sergey12malyshev/Smart-power-supply-350W/README.txt

Программный проект импульсного источника питания.
Среда компиляции:KEIL.uVision V5.34.0.0
Настройка периферии: STM32 CubeMX
Контроллер: STM32F103C8T6
RTOS:FreeRTOS Kernel V10.0.1 (https://microtechnics.ru/stm32cubemx-bystryj-start-s-freertos-dlya-stm32/)
Сборка: Proba.BAT (Options for target ... -> Вкладка "Output" -> Галка "Create batch file")
