sergey12malyshev/Smart-power-supply-350W/hardware/picturies/CLI.bmp

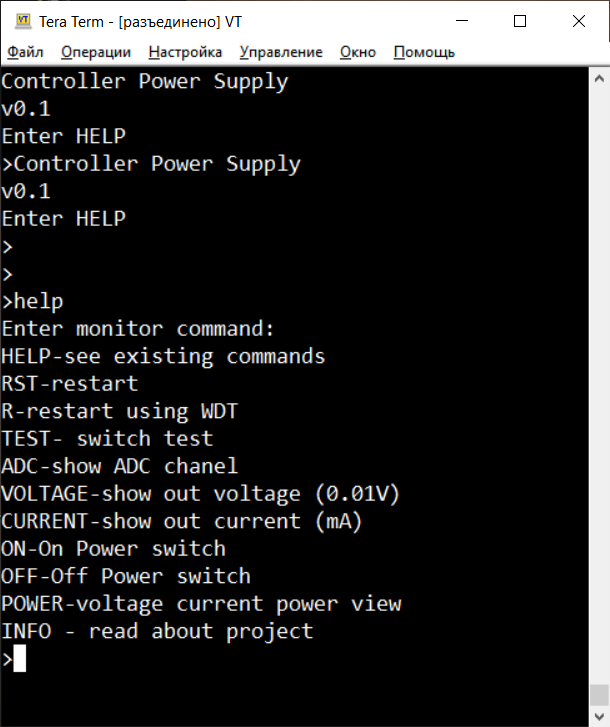
hardware/picturies/CLI.bmp
