sergey12malyshev/Smart-power-supply-350W/hardware/picturies/Модель LTSpice.png

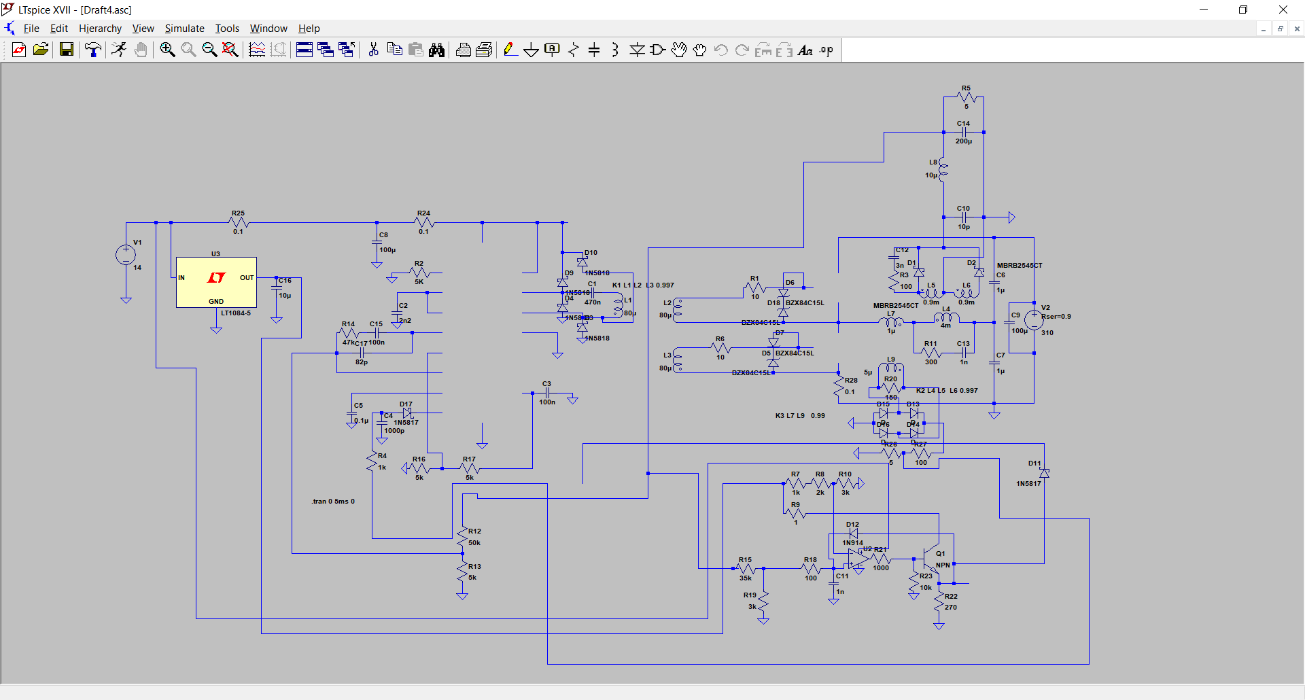
hardware/picturies/Модель LTSpice.png
