sergey12malyshev/Smart-power-supply-350W/hardware/shemes/Э1 Схема структурная.pdf

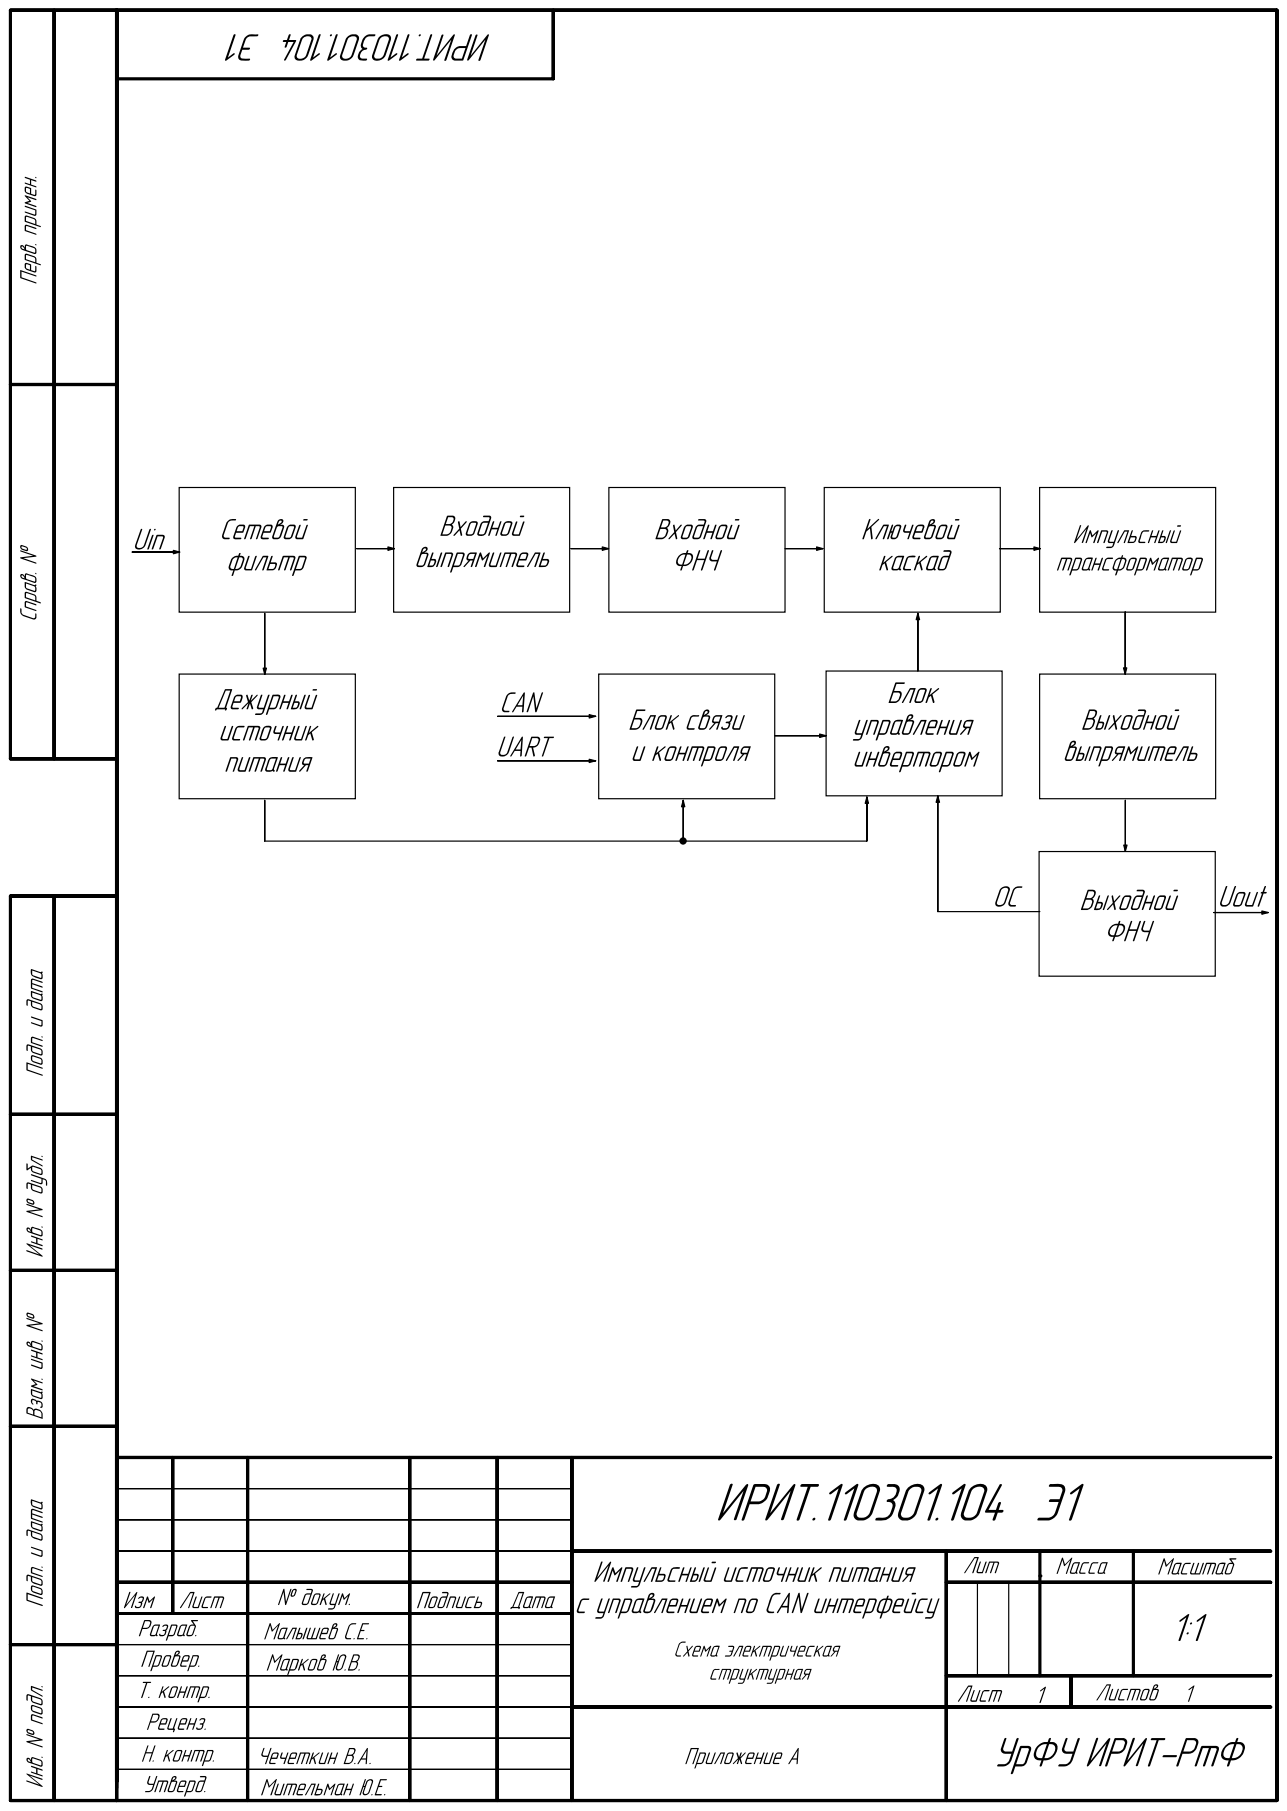
[picture p6: page 1]
