sergey12malyshev/Smart-power-supply-350W/hardware/shemes/Э3 Модуль связи и контроля.pdf

DA5

a[7..0]

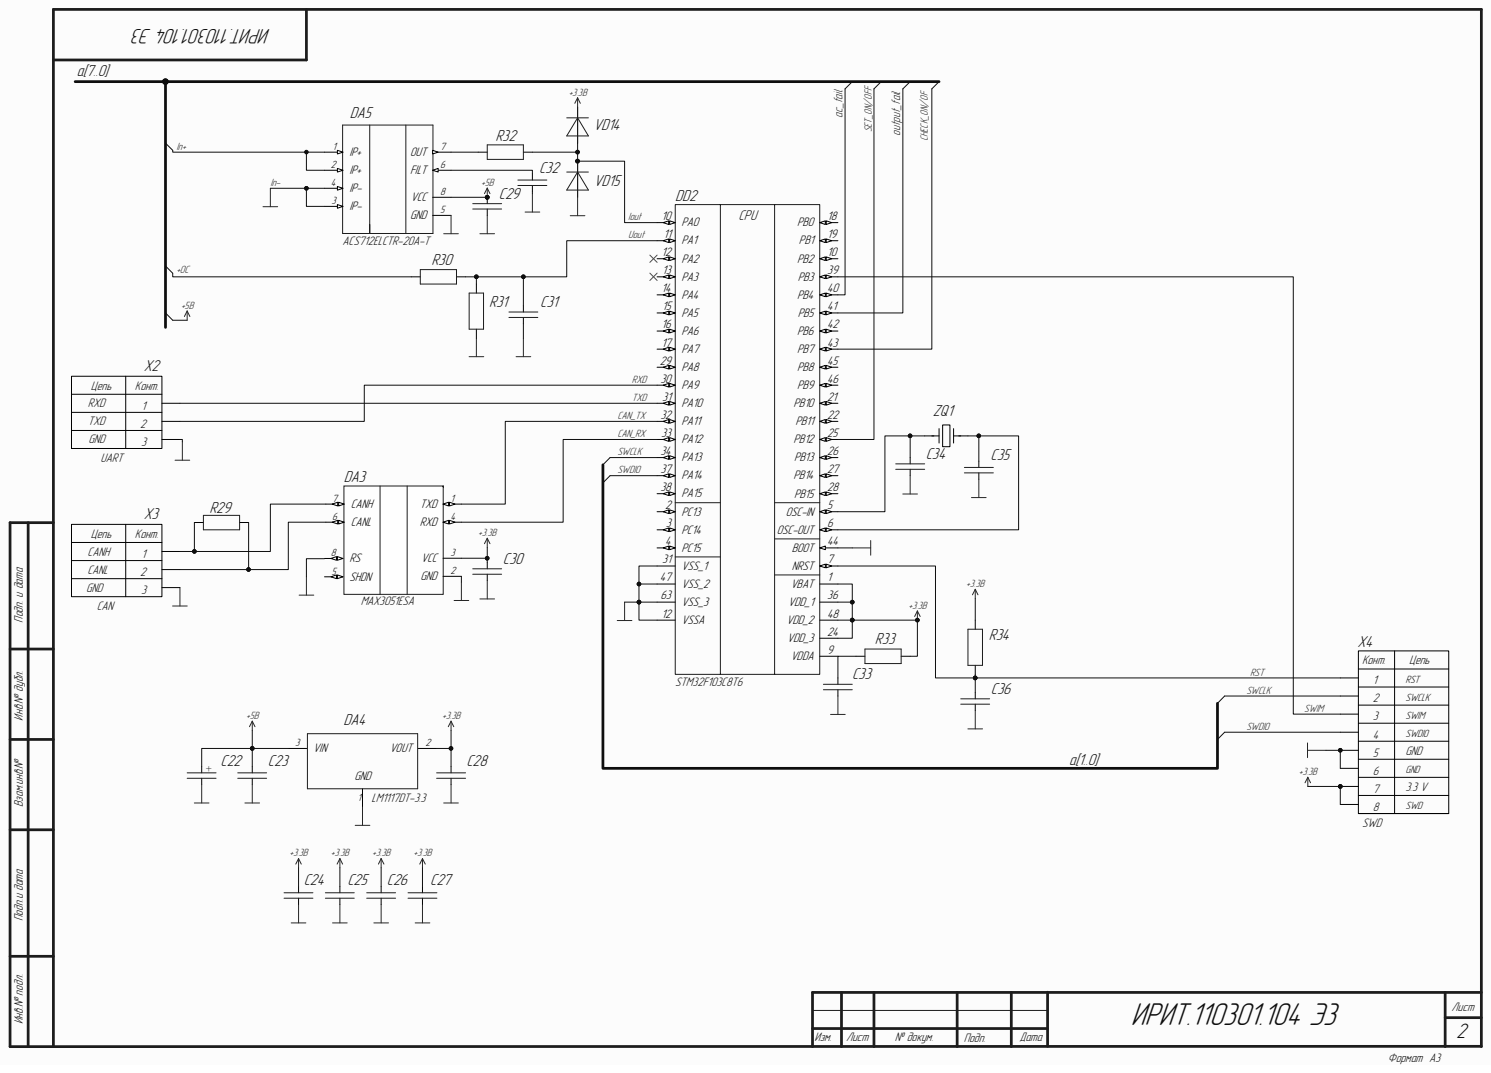
[picture p7: page 1]

Èíâ.¹ ïîäë. Ïîäï.è äàòà Âçàì.èíâ.¹ Èíâ.¹ äóáë. Ëèñò

ÈÐÈÒ.110301.104 Ý3

Èçì. | Ëèñò | ¹ äîêóì. | Ïîäï. | Äàòà
