sergey12malyshev/Smart-power-supply-350W/hardware/shemes/Э3 Модуль управления преобразованием и защит.pdf

C13

DA2

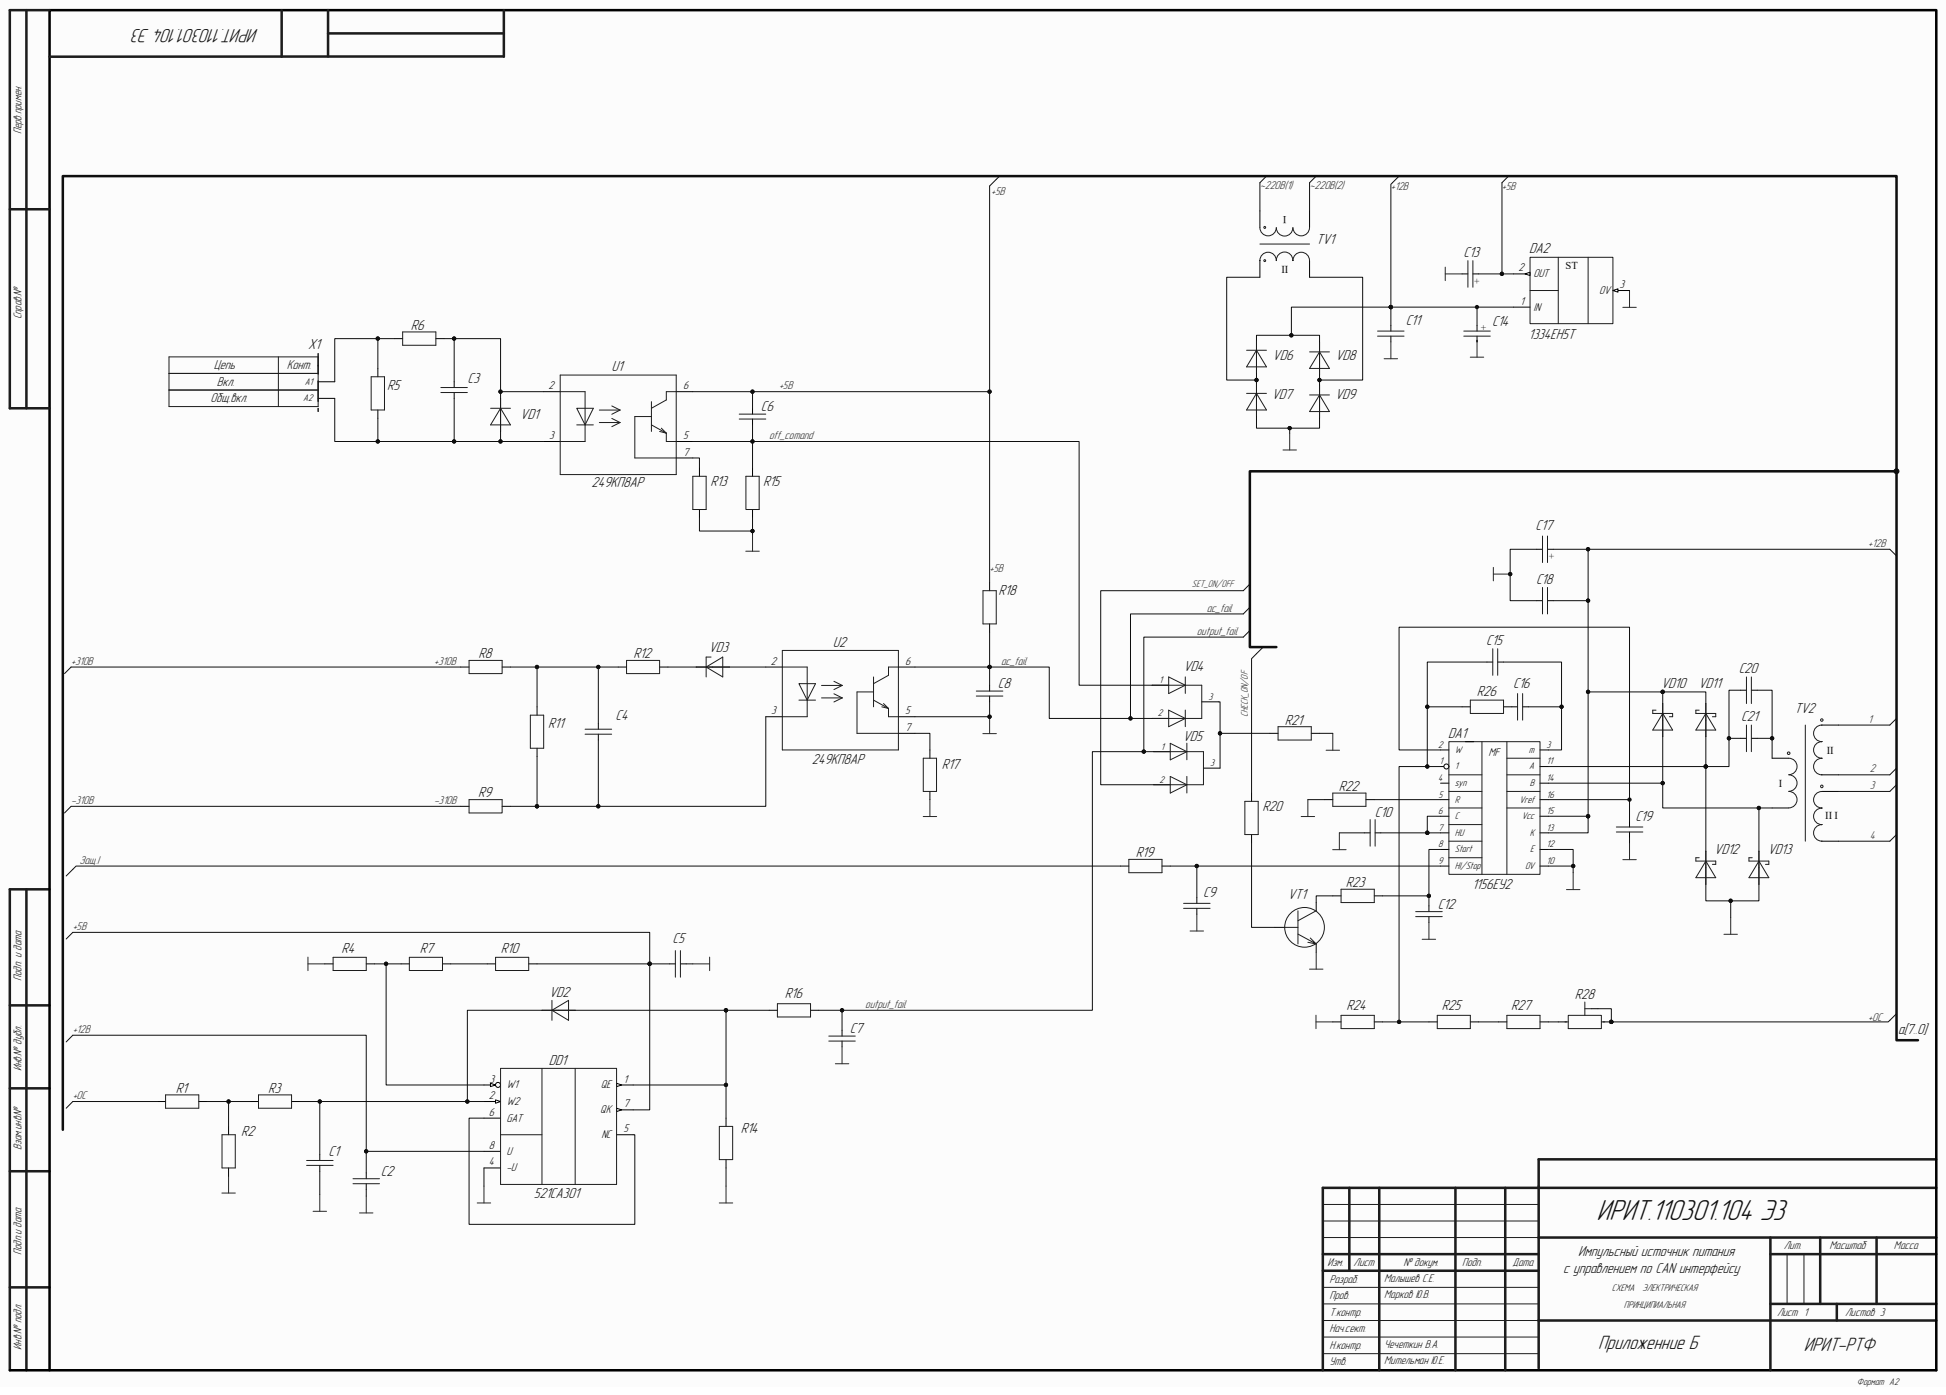
[picture p8: page 1]

Öåïü | Êîíò.
Âêë. | A1

Èíâ.¹ ïîäë. Ïîäï.è äàòà Âçàì.èíâ.¹ Èíâ.¹ äóáë. Ïîäï. è äàòà

Èìïóëüñíûé èñòî÷íèê ïèòàíèÿ
ñ óïðàâëåíèåì ïî CAN èíòåðôåéñó

Èçì. | Ëèñò | ¹ äîêóì. | Ïîäï. | Äàòà
Ðàçðàá. | | Ìàëûøåâ Ñ.Å.
Ïðîâ. | | Ìàðêîâ Þ.Â.
Ò.êîíòð. Íà÷.ñåêò.

Í.êîíòð. | | ×å÷åòêèí Â.À.
