sergey12malyshev/Smart-power-supply-350W/hardware/shemes/Э3 Силовой модуль.pdf

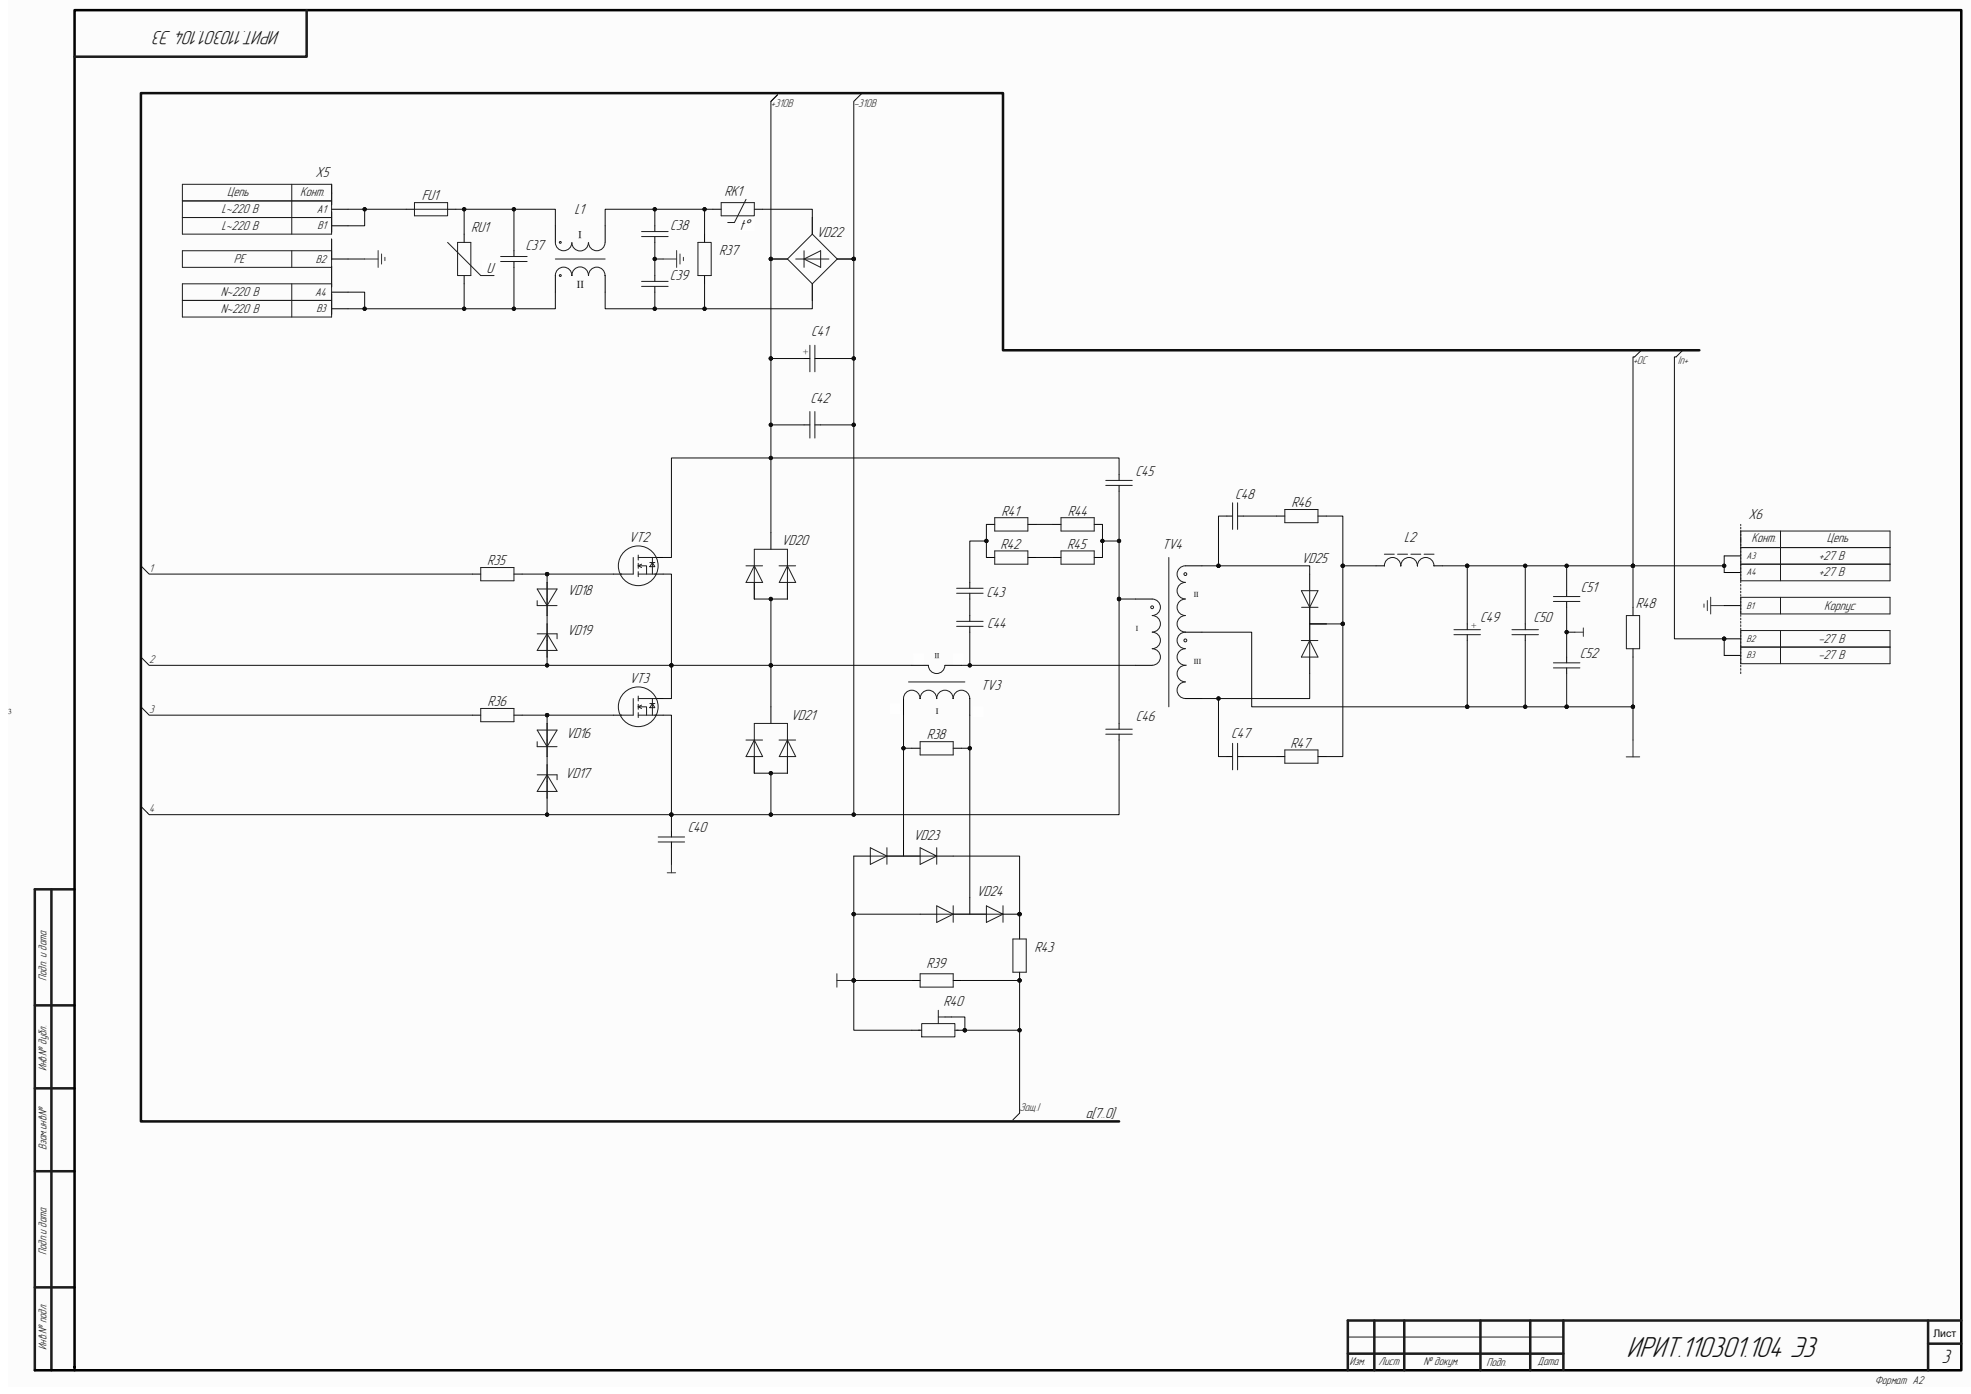
[picture p9: page 1]

Öåïü | Êîíò.
L~220 Â | A1

N~220 Â | A4
N~220 Â | B3

A3 | +27 Â
A4 | +27 Â

B2 | -27 Â
B3 | -27 Â

Èíâ.¹ ïîäë. Ïîäï.è äàòà Âçàì.èíâ.¹ Èíâ.¹ äóáë. Ïîäï. è äàòà
