sergey12malyshev/Smart-power-supply-350W/(list of files, drawings)

Other design files:
hardware/pcb/SMPS24.lay
hardware/pcb/Плата защиты.lay
