sergey12malyshev/Smart-power-supply-350W/Core/Src/main.c

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
/* Includes ------------------------------------------------------------------*/
#include "main.h"
#include "cmsis_os.h"

/* USER CODE BEGIN Includes */
#include <stdio.h>
#include <string.h>	
#include <stdbool.h>
#include "task.h"
#include "hardware.h"
#include "mainTask.h"
#include "monitorTask.h"
#include "checkTask.h"
#include "ADC.h"
/* USER CODE END Includes */

ADC_HandleTypeDef hadc1;
ADC_HandleTypeDef hadc2;

IWDG_HandleTypeDef hiwdg;

UART_HandleTypeDef huart1;

/* Definitions for defaultTask */
osThreadId_t defaultTaskHandle;
const osThreadAttr_t defaultTask_attributes = {
  .name = "defaultTask",
  .stack_size = 128 * 4,
  .priority = (osPriority_t) osPriorityNormal,
};
/* Definitions for mainTask */
osThreadId_t mainTaskHandle;
const osThreadAttr_t mainTask_attributes = {
  .name = "mainTask",
  .stack_size = 128 * 4,
  .priority = (osPriority_t) osPriorityLow,
};
/* Definitions for checkTask */
osThreadId_t checkTaskHandle;
const osThreadAttr_t checkTask_attributes = {
  .name = "checkTask",
  .stack_size = 128 * 4,
  .priority = (osPriority_t) osPriorityLow,
};
/* Definitions for monitorTask */
osThreadId_t monitorTaskHandle;
const osThreadAttr_t monitorTask_attributes = {
  .name = "monitorTask",
  .stack_size = 128 * 4,
  .priority = (osPriority_t) osPriorityLow,
};
void SystemClock_Config(void);
static void MX_GPIO_Init(void);
static void MX_USART1_UART_Init(void);
static void MX_ADC1_Init(void);
static void MX_ADC2_Init(void);
static void MX_IWDG_Init(void);
void StartDefaultTask(void *argument);
void StartMainTask(void *argument);
void StartCheckTask(void *argument);
void StartMonitorTask(void *argument);

/**
  * @brief  The application entry point.
  * @retval int
  */
int main(void)
{
  /* MCU Configuration--------------------------------------------------------*/

  /* Reset of all peripherals, Initializes the Flash interface and the Systick. */
  HAL_Init();

  /* Configure the system clock */
  SystemClock_Config();

  /* Initialize all configured peripherals */
  MX_GPIO_Init();
  MX_USART1_UART_Init();
  MX_ADC1_Init();
  MX_ADC2_Init();
  MX_IWDG_Init();
  /* USER CODE BEGIN 2 */
  HAL_ADCEx_Calibration_Start(&hadc1);
  
  off_ps(); 

  clear_uart_buff();
  UART_receve_IT();
  sendUART_hello();
  HAL_NVIC_EnableIRQ(EXTI15_10_IRQn);

  if (adc2_convertion() >= 3030) /* При сбросе пропускаем калибровку, если была нагрузка*/
  {
    calibr_zero_AD712();
  }
  else 
  {
    setZeroAD712(2450); // установим значение по умолчанию
  }
  
  /* USER CODE END 2 */

  /* Init scheduler */
  osKernelInitialize();

  /* USER CODE BEGIN RTOS_MUTEX */
  /* add mutexes, ... */
  /* USER CODE END RTOS_MUTEX */

  /* USER CODE BEGIN RTOS_SEMAPHORES */
  /* add semaphores, ... */
  /* USER CODE END RTOS_SEMAPHORES */

  /* USER CODE BEGIN RTOS_TIMERS */
  /* start timers, add new ones, ... */
  /* USER CODE END RTOS_TIMERS */

  /* USER CODE BEGIN RTOS_QUEUES */
  /* add queues, ... */
  /* USER CODE END RTOS_QUEUES */

  /* Create the thread(s) */
  /* creation of defaultTask */
  defaultTaskHandle = osThreadNew(StartDefaultTask, NULL, &defaultTask_attributes);

  /* creation of mainTask */
  mainTaskHandle = osThreadNew(StartMainTask, NULL, &mainTask_attributes);

  /* creation of checkTask */
  checkTaskHandle = osThreadNew(StartCheckTask, NULL, &checkTask_attributes);

  /* creation of monitorTask */
  monitorTaskHandle = osThreadNew(StartMonitorTask, NULL, &monitorTask_attributes);

  /* USER CODE BEGIN RTOS_THREADS */
  /* add threads, ... */
  /* USER CODE END RTOS_THREADS */

  /* USER CODE BEGIN RTOS_EVENTS */
  /* add events, ... */
  /* USER CODE END RTOS_EVENTS */

  /* Start scheduler */
  osKernelStart();

  /* We should never get here as control is now taken by the scheduler */
  /* Infinite loop */
  /* USER CODE BEGIN WHILE */
  while (1)
  {
    /* USER CODE END WHILE */

    /* USER CODE BEGIN 3 */
  }
  /* USER CODE END 3 */
}

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
/* USER CODE BEGIN 4 */
void HAL_GPIO_EXTI_Callback(uint16_t GPIO_Pin)
{
	if (HAL_GPIO_ReadPin(GPIOA, GPIO_PIN_5)==0)
  {
    ;
  }
}
/* USER CODE END 4 */

/* USER CODE BEGIN Header_StartDefaultTask */
/**
  * @brief  Function implementing the defaultTask thread.
  * @param  argument: Not used
  * @retval None
  */
/* USER CODE END Header_StartDefaultTask */
void StartDefaultTask(void *argument)
{
  /* USER CODE BEGIN 5 */
  /* Infinite loop */
  for(;;)
  {
    osDelay(1);
		reset_WDT();
  }
  /* USER CODE END 5 */
}

/* USER CODE BEGIN Header_StartMainTask */
/**
* @brief Function implementing the mainTask thread.
* @param argument: Not used
* @retval None
*/
/* USER CODE END Header_StartMainTask */
void StartMainTask(void *argument)
{
  /* USER CODE BEGIN StartMainTask */
  mainTask();
  /* USER CODE END StartMainTask */
}

/* USER CODE BEGIN Header_StartCheckTask */
/**
* @brief Function implementing the checkTask thread.
* @param argument: Not used
* @retval None
*/
/* USER CODE END Header_StartCheckTask */
void StartCheckTask(void *argument)
{
  /* USER CODE BEGIN StartCheckTask */
  checkTask();
  /* USER CODE END StartCheckTask */
}

/* USER CODE BEGIN Header_StartMonitorTask */
/**
* @brief Function implementing the monitorTask thread.
* @param argument: Not used
* @retval None
*/
/* USER CODE END Header_StartMonitorTask */
void StartMonitorTask(void *argument)
{
  /* USER CODE BEGIN StartMonitorTask */
  monitorTask();
  /* USER CODE END StartMonitorTask */
}

/**
  * @brief  Period elapsed callback in non blocking mode
  * @note   This function is called  when TIM1 interrupt took place, inside
  * HAL_TIM_IRQHandler(). It makes a direct call to HAL_IncTick() to increment
  * a global variable "uwTick" used as application time base.
  * @param  htim : TIM handle
  * @retval None
  */
void HAL_TIM_PeriodElapsedCallback(TIM_HandleTypeDef *htim)
{
  if (htim->Instance == TIM1) {
    HAL_IncTick();
  }
}

/**
  * @brief  This function is executed in case of error occurrence.
  * @retval None
  */
void Error_Handler(void)
{
  /* USER CODE BEGIN Error_Handler_Debug */
  /* User can add his own implementation to report the HAL error return state */
  __disable_irq();
  while (1)
  {
  }
  /* USER CODE END Error_Handler_Debug */
}

#ifdef  USE_FULL_ASSERT
/**
  * @brief  Reports the name of the source file and the source line number
  *         where the assert_param error has occurred.
  * @param  file: pointer to the source file name
  * @param  line: assert_param error line source number
  * @retval None
  */
void assert_failed(uint8_t *file, uint32_t line)
{
  /* USER CODE BEGIN 6 */
  /* User can add his own implementation to report the file name and line number,
     ex: printf("Wrong parameters value: file %s on line %d\r\n", file, line) */
  /* USER CODE END 6 */
}
#endif /* USE_FULL_ASSERT */

/************************ (C) COPYRIGHT STMicroelectronics *****END OF FILE****/
