sergey12malyshev/Smart-power-supply-350W/Core/Inc/main.h

#define DEBUG            1
#define VERSION_MAJOR    0U
#define VERSION_MINOR    2U
#define VERSION_PATCH    1U
#define LED_Pin GPIO_PIN_12
#define LED_GPIO_Port GPIOB
#define heartbeat_led_Pin GPIO_PIN_9
#define heartbeat_led_GPIO_Port GPIOB
