sergey12malyshev/Smart-power-supply-350W/Core/Src/mainTask.c

#include "FreeRTOS.h"
#include "task.h"
#include "main.h"
#include "hardware.h"
#include "mainTask.h"
#include "ADC.h"

uint16_t voltage;
uint16_t voltage_av;
uint16_t current;

/* Экспоненциальное бегущее среднее  filt = (A * filt + signal) >> k, https://alexgyver.ru/lessons/filters/ */
uint16_t expRunningAverageFilter(uint16_t input)
{
  static uint32_t filt = 0;
  const uint8_t k = 3;
  const uint8_t a = 7; // a =  (2^k) – 1

  filt = (a * filt + input) >> k;

  return filt;
}

void voltageConvertion(uint16_t adc_1)
{
  voltage = (adc_1 * 33 * 107) / 4096; // 9,1K 910 OHM -> 11*3=33 (36)V MAX INPUT
}

void currentConvertion(uint16_t adc_2)
{
  uint16_t volt_do_current = ((adc_2 * 3300) / 4096);
  if (volt_do_current < getZeroAD712())
  {
    current = (getZeroAD712() - volt_do_current) * 10; // ACS712 invert connect
  }
  else
  {
    current = 0;
  }
}

/*
* sЗадача запуска преобразований АЦП и преобразований физических величин
*/
void mainTask(void)
{
  TickType_t xLastWakeTime;
  const TickType_t xFrequency = 10 / portTICK_PERIOD_MS; // 10 ms period TASK
  xLastWakeTime = xTaskGetTickCount();

  uint32_t task10msCnt = 0, lastCnt = 0; 
  uint16_t heartbeatPeriod_ms = 850;
  for (;;)
  {
    task10msCnt++;
    if (task10msCnt - lastCnt >= heartbeatPeriod_ms / 10)
    {
      lastCnt = task10msCnt;
      heartbeatLedToggle();
    }
    
    setADC1value(adc1_convertion());
    setADC2value(adc2_convertion());

    voltageConvertion(getADC1value());
    currentConvertion(getADC2value());

    voltage_av = expRunningAverageFilter(voltage);

    reset_WDT();
    vTaskDelayUntil(&xLastWakeTime, xFrequency);
  }
}
