sergey12malyshev/Smart-power-supply-350W/Core/Inc/hardware.h

#ifndef __HARD_H
#define __HARD_H

#include <stdbool.h>

void reset_WDT(void);
void on_ps(void);
void off_ps(void);
void heartbeatLedToggle(void);
bool PinPowerEnableState(void);
bool checkStatePower(void);
#endif /* __HARD_H */
