sergey12malyshev/Smart-power-supply-350W/Core/Inc/monitorTask.h

#ifndef __MONITOR_H
#define __MONITOR_H

#include <stdint.h> /*бъявляет целочисленные типы*/

void monitorTask(void);

void clear_uart_buff(void);
void UART_receve_IT(void);
void sendUART(uint8_t TxBufferUartLocal[]);
void sendUART_WARNING(void);
void sendUART_hello(void);

#endif /* __MONITOR_H */
