sergey12malyshev/Smart-power-supply-350W/(commit log)

2022-06-25 Первый коммит
2022-06-25 Добавление в игнор файла проекта Добавление readme файла
2022-06-26 Пересборка проекта
2022-06-26 Портирована FreeRTOS
2022-06-26 Реализованы задачи
2022-06-26 условие на локальное эхо
2022-06-26 Сделал локальный буфер для терминала Доработал тест сброса по WDT
2022-06-26 Реализован терминал с >
2022-06-26 Работа над терминалом. Реализована отдельная функция вывода значений в терминал. Enter прерывает выполнение теста
2022-06-26 Доработан терминал
2022-06-26 Создание команды VIEW отображающей значения напряжения, тока и мощности
2022-06-26 ссылка про freertos
2023-01-04 1. Отклюяение генерации неиспользуемых библиотек
2023-01-04 Устранение ошибок компиляци
2023-01-04 Перенос задачи монитора в отдельный файл
2023-01-04 Большой рефакторинг проекта
2023-01-04 рефакторинг модуля монитора
2023-01-04 рефакторинг монитора
2023-01-04 Переработка монитора
2023-01-04 Работа с терминалом
2023-01-05 1. Добавление файла проекта VScode 2. Добавление скрипта програмиирования Flash 3. Изменение формата файла README.md 4. Добавление файлов настроек терминальной программы
2023-01-05 Форматирование
2023-01-05 Переработка ADC
2023-01-05 Переделан алгоритм контроля срабатывания защит
2023-01-05 Поправил README.md
2023-01-05 Выделение в отдельный файл задачи безопасности
2023-01-05 Создание отдельной директории под железо
2023-01-05 Добавление описания и исходников по аппаратной части
    [SMPS24.lay, Плата защиты.lay]
2023-01-05 Добавление схем
2023-01-05 Перемещение
2023-01-08 Добавление автомата состояний
2023-01-08 Правки терминала
2023-01-08 Калибровка нуля датчика тока происходит только при отсутствии тока
2023-02-02 Скрин CLI.bmp
2023-02-17 Рефакторинг - не проверял в железе
2023-02-20 Добавлен скрипт запуска сборки проекта Добавлен скрипт запуска терминала PuTTY
2023-03-08 Удаление мертвого кода, добавил описание
2023-03-08 Правка описания
2023-03-22 Рефакторинг, избавление от глобальных переменных
2023-03-22 Вынесение логи работы с АЦП в отдельный модуль
2023-03-22 Введение контроля перегрузки по току и по превышению напряжения в дополнение к аппаратным защитам
2023-03-23 Добавлен усредняющий фильтр
2023-04-08 Добавлен heartbeat светодиод
2023-04-08 Выводим в консоль версию freertos
2023-04-08 Выводим в команде info версию RTOS и HAL
2023-04-08 Изменение версии ПО
2023-04-09 В проект добавлен скрипт для запуска статического анализатора кода
2023-04-09 1. Устранены проблемы выявленные статическим анализатором 2. Доработан монитор
2023-04-09 Доработка монитора
2023-04-09 В скрипте запуска стат. анализа добавлена возможность вывода в файл
2023-04-10 Добавил ссылку на интересную статью
2023-04-13 Доработка скрипта
2023-04-18 Добавил изображение структурной схемы
2023-04-23 Работа с АЦП
